BeaverHorror/STM32F407ZET6_MyPhone/Media/IMG_20260402_200926.jpg

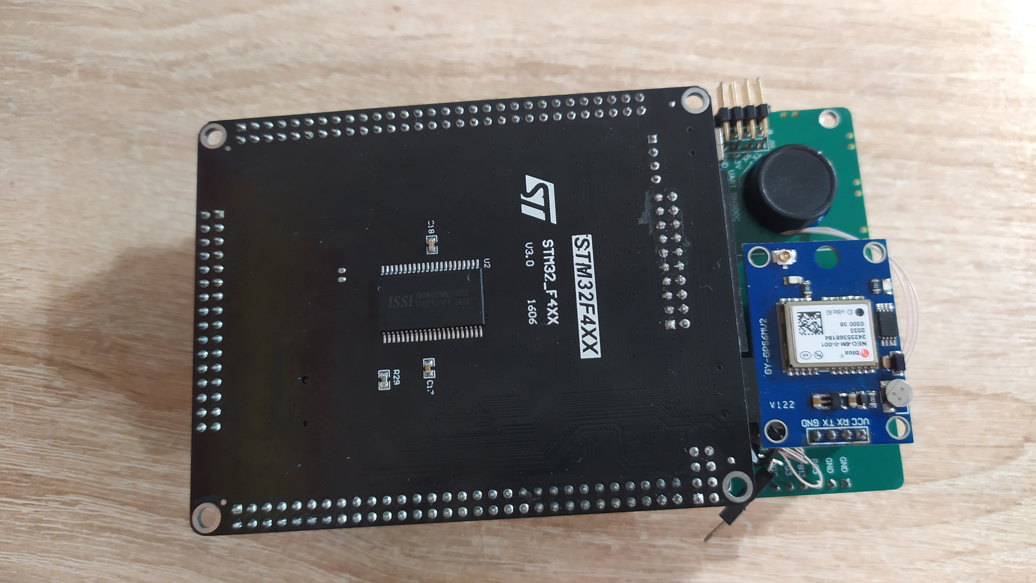
Media/IMG_20260402_200926.jpg
