BeaverHorror/STM32F407ZET6_MyPhone/Media/IMG_20260402_200939.jpg

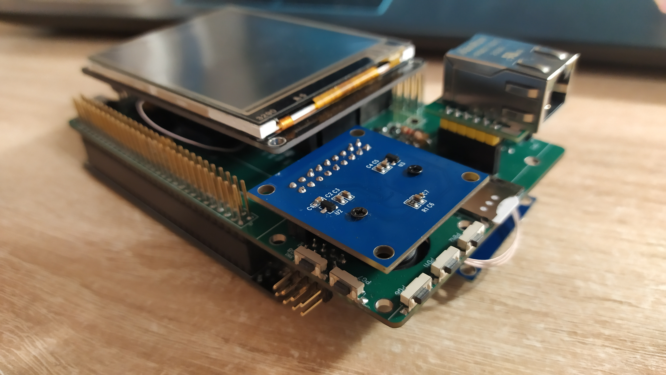
Media/IMG_20260402_200939.jpg
