BeaverHorror/STM32F407ZET6_MyPhone/Other/ESP8266_STM32_OTA_2022/OTA ESP8266 STM32 SIM800l.png

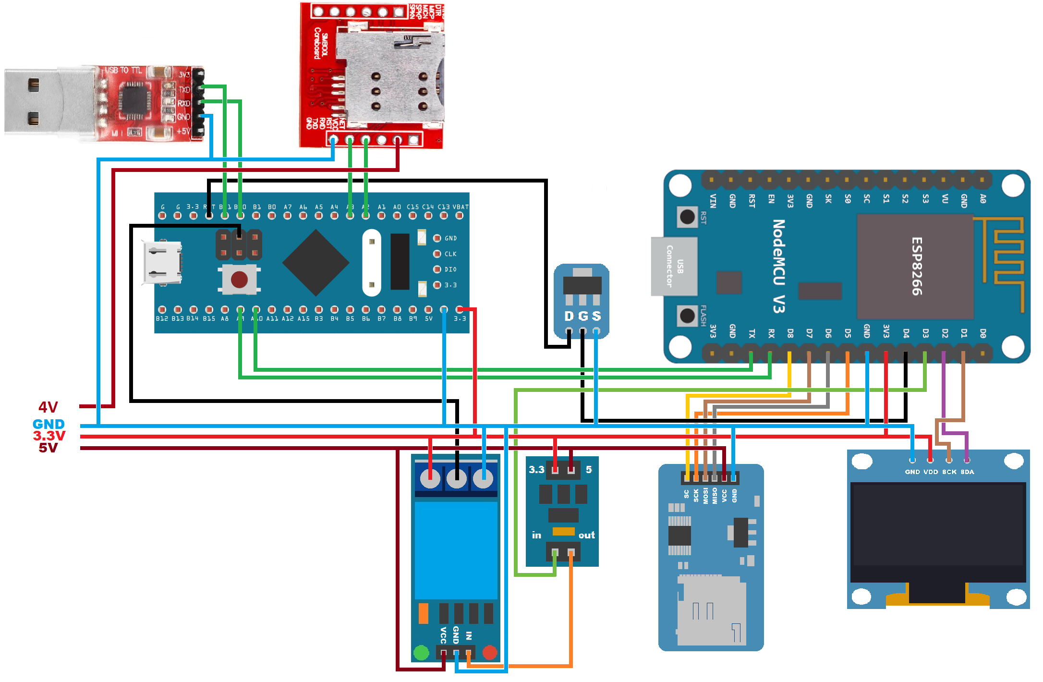
Other/ESP8266_STM32_OTA_2022/OTA ESP8266 STM32 SIM800l.png
