BeaverHorror/STM32F407ZET6_MyPhone/Other/pinset (1).png

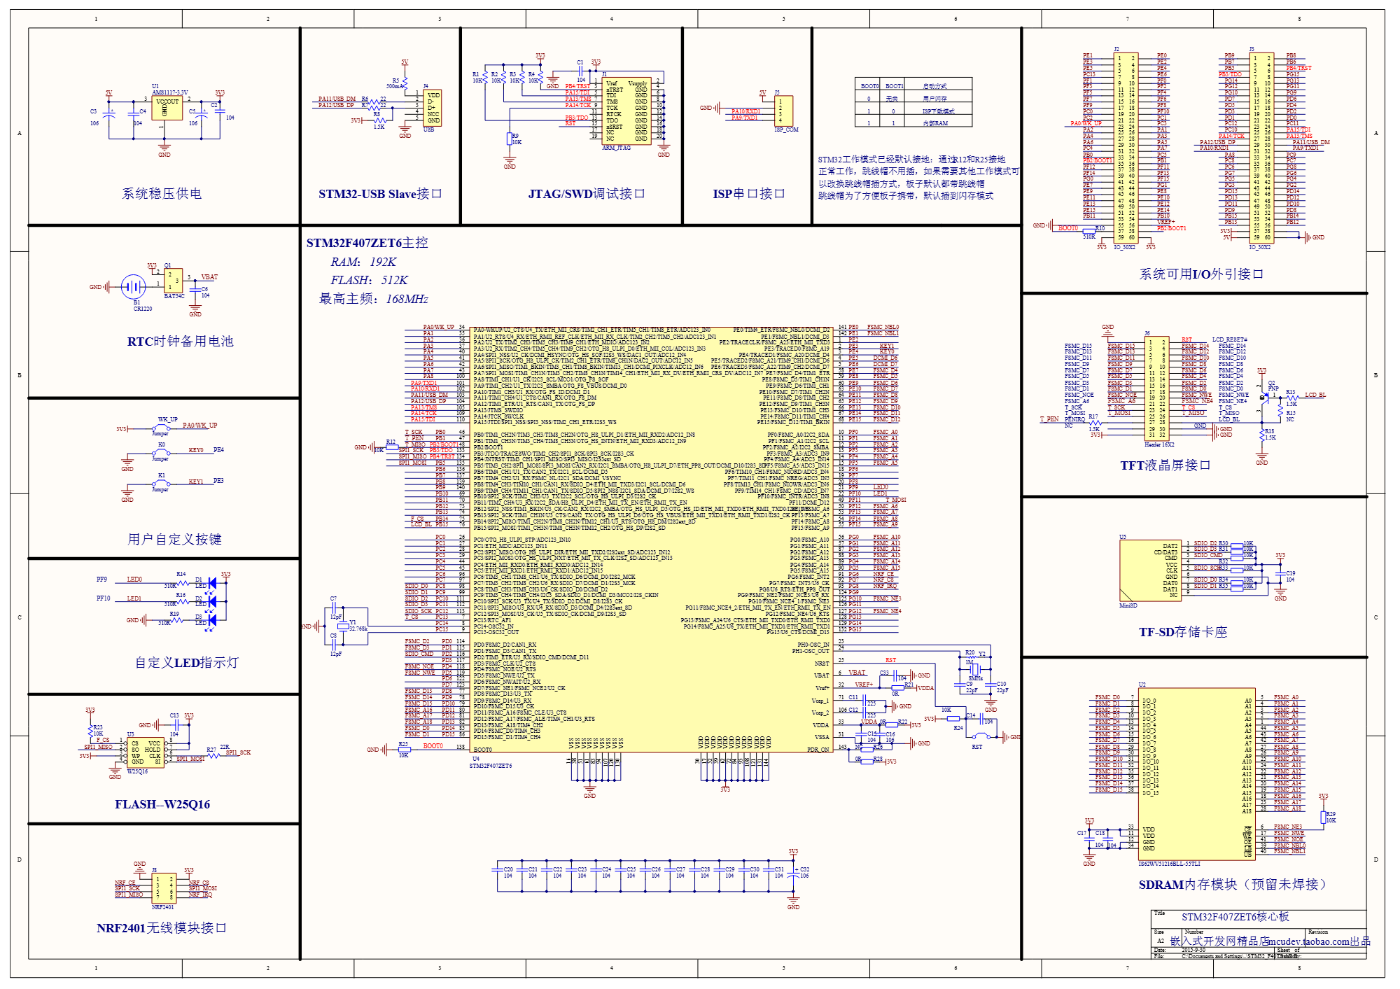
Other/pinset (1).png
