BeaverHorror/STM32F407ZET6_MyPhone/Other/pinset (2).png

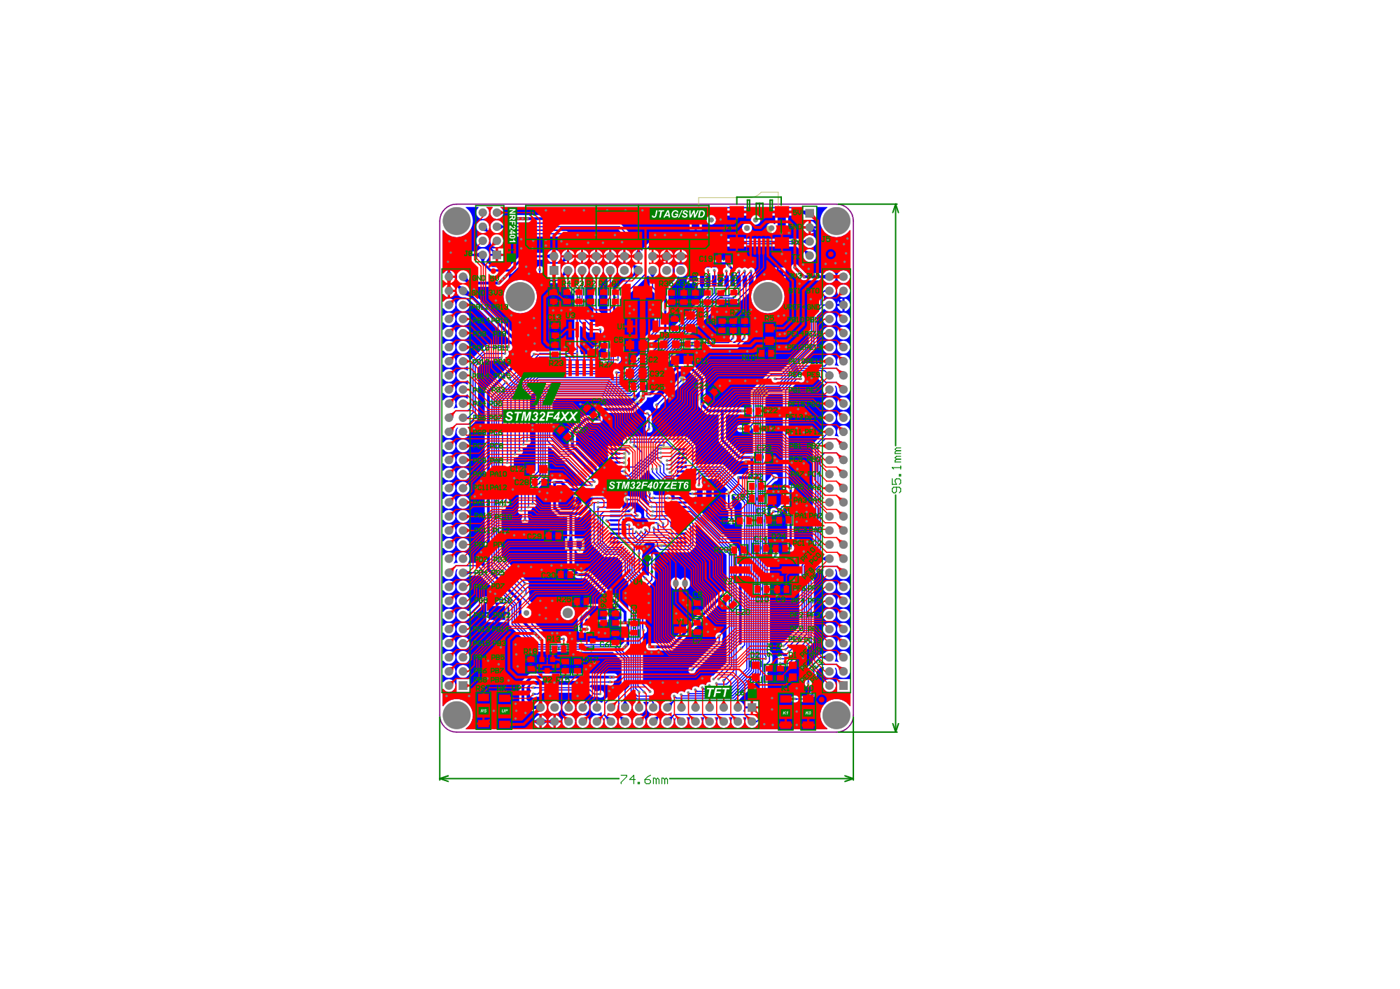
Other/pinset (2).png
