BeaverHorror/STM32F407ZET6_MyPhone/Other/pinset (3).png

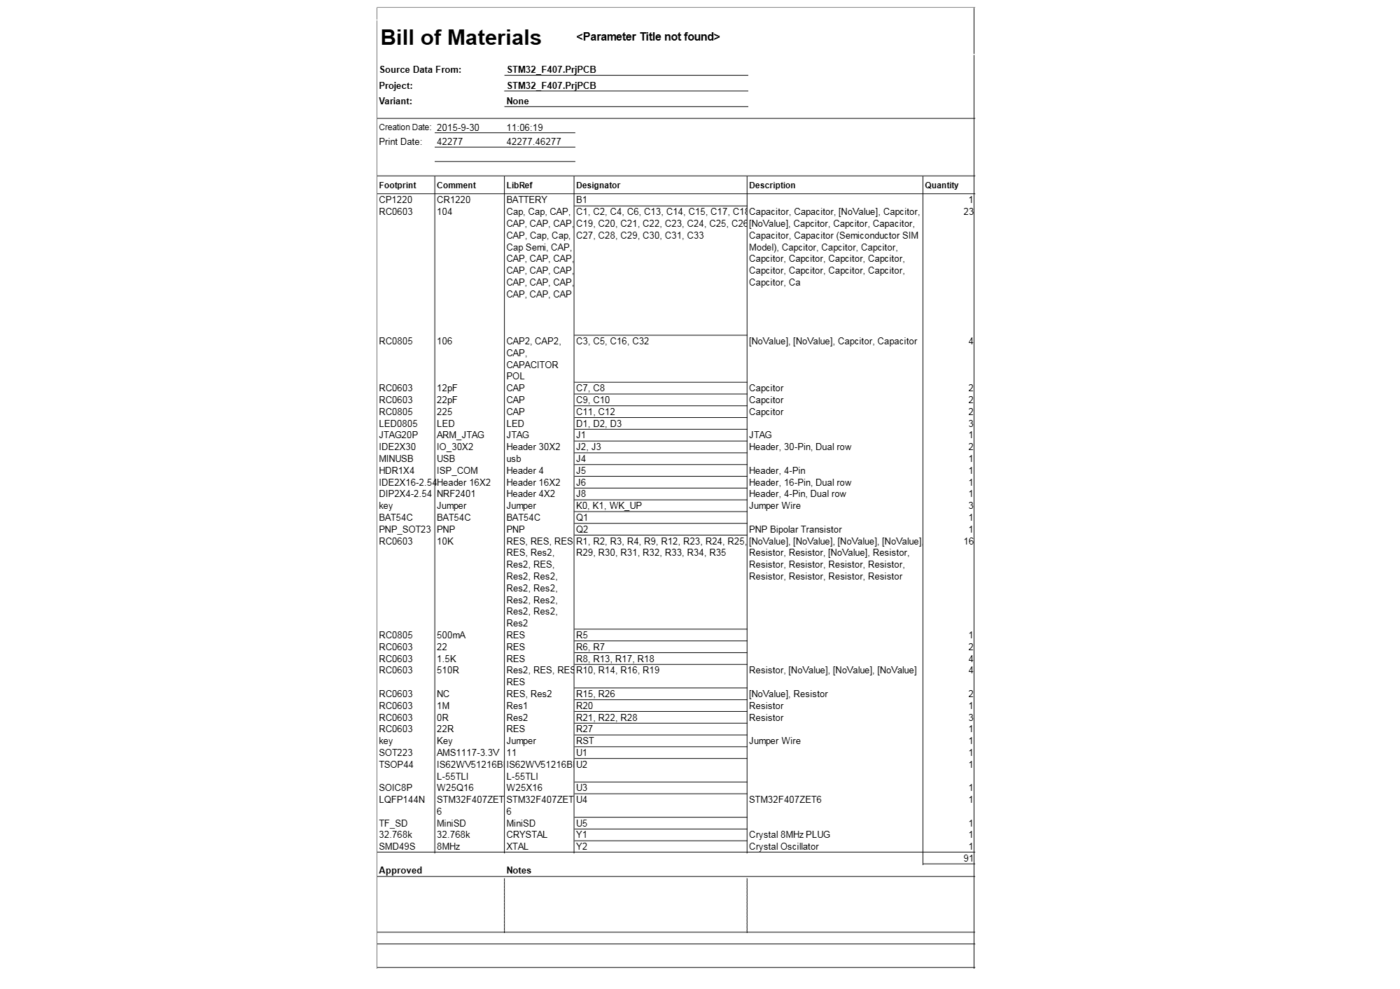
Other/pinset (3).png
