BeaverHorror/STM32F407ZET6_MyPhone/Other/загрузка (1).png

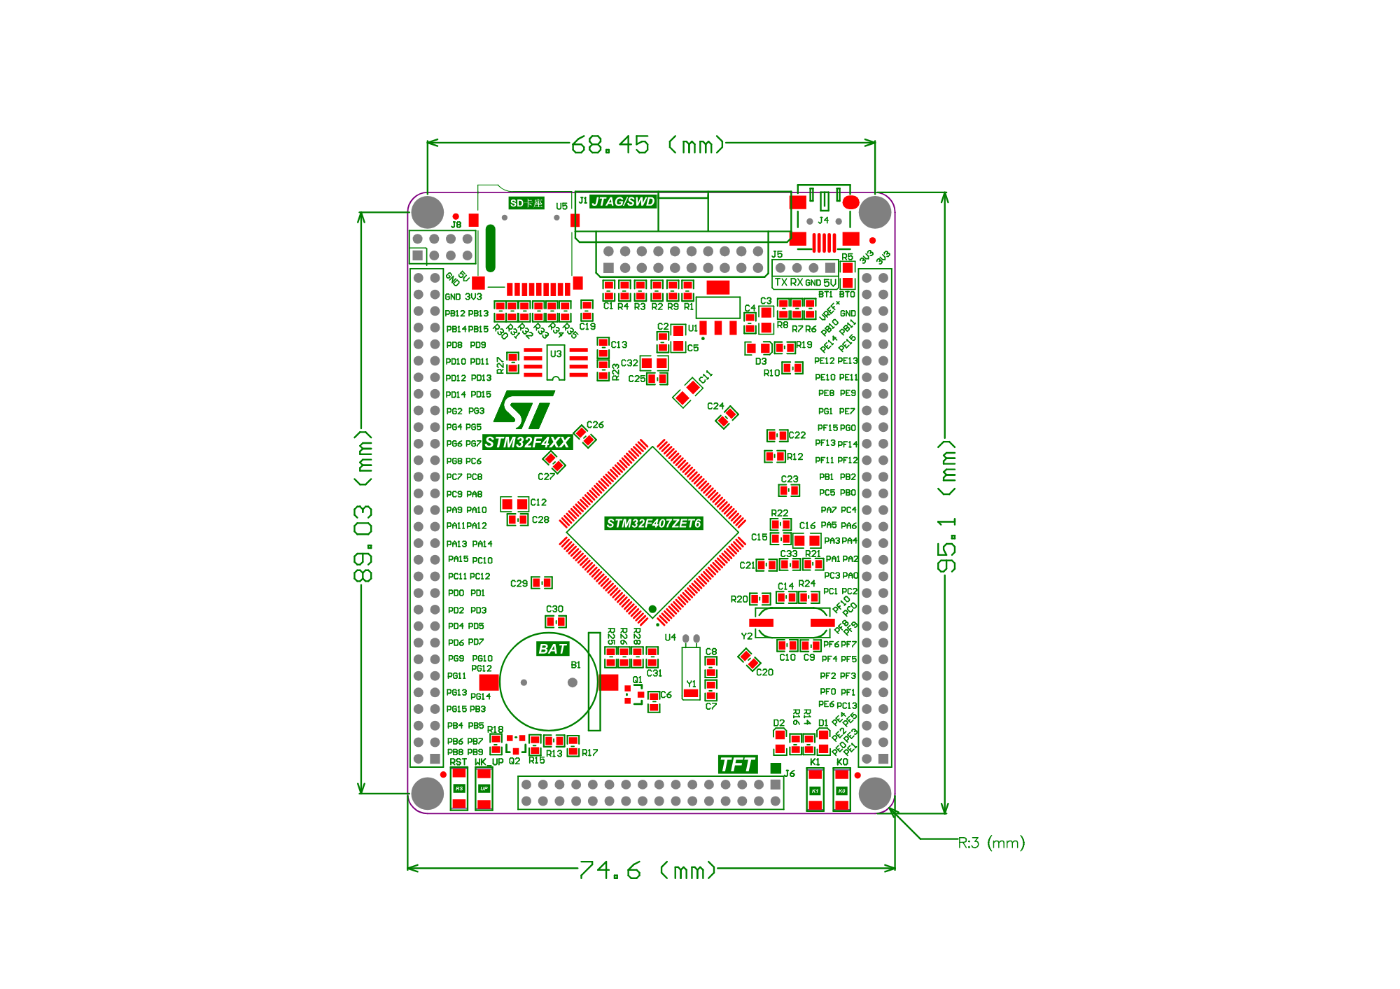
Other/загрузка (1).png
