BeaverHorror/STM32F407ZET6_MyPhone/Other/Скриншот 19-08-2025 135712.jpg

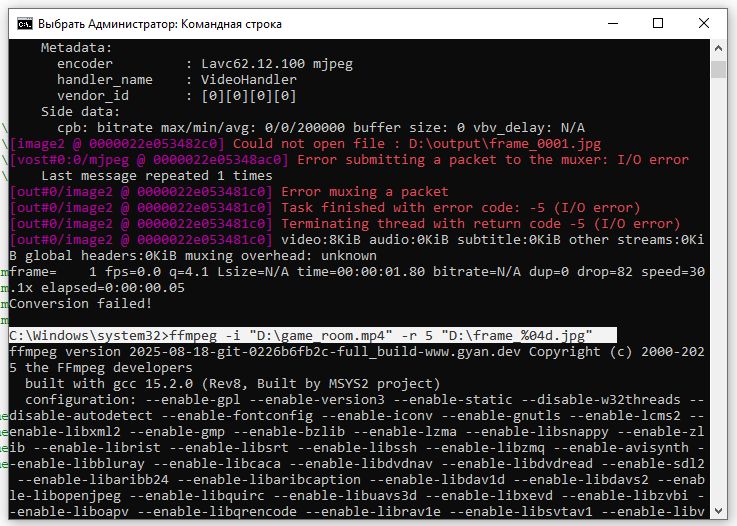
Other/Скриншот 19-08-2025 135712.jpg
