BeaverHorror/STM32F407ZET6_MyPhone/Schematic/Schematic_Communication_2026-04-02.png

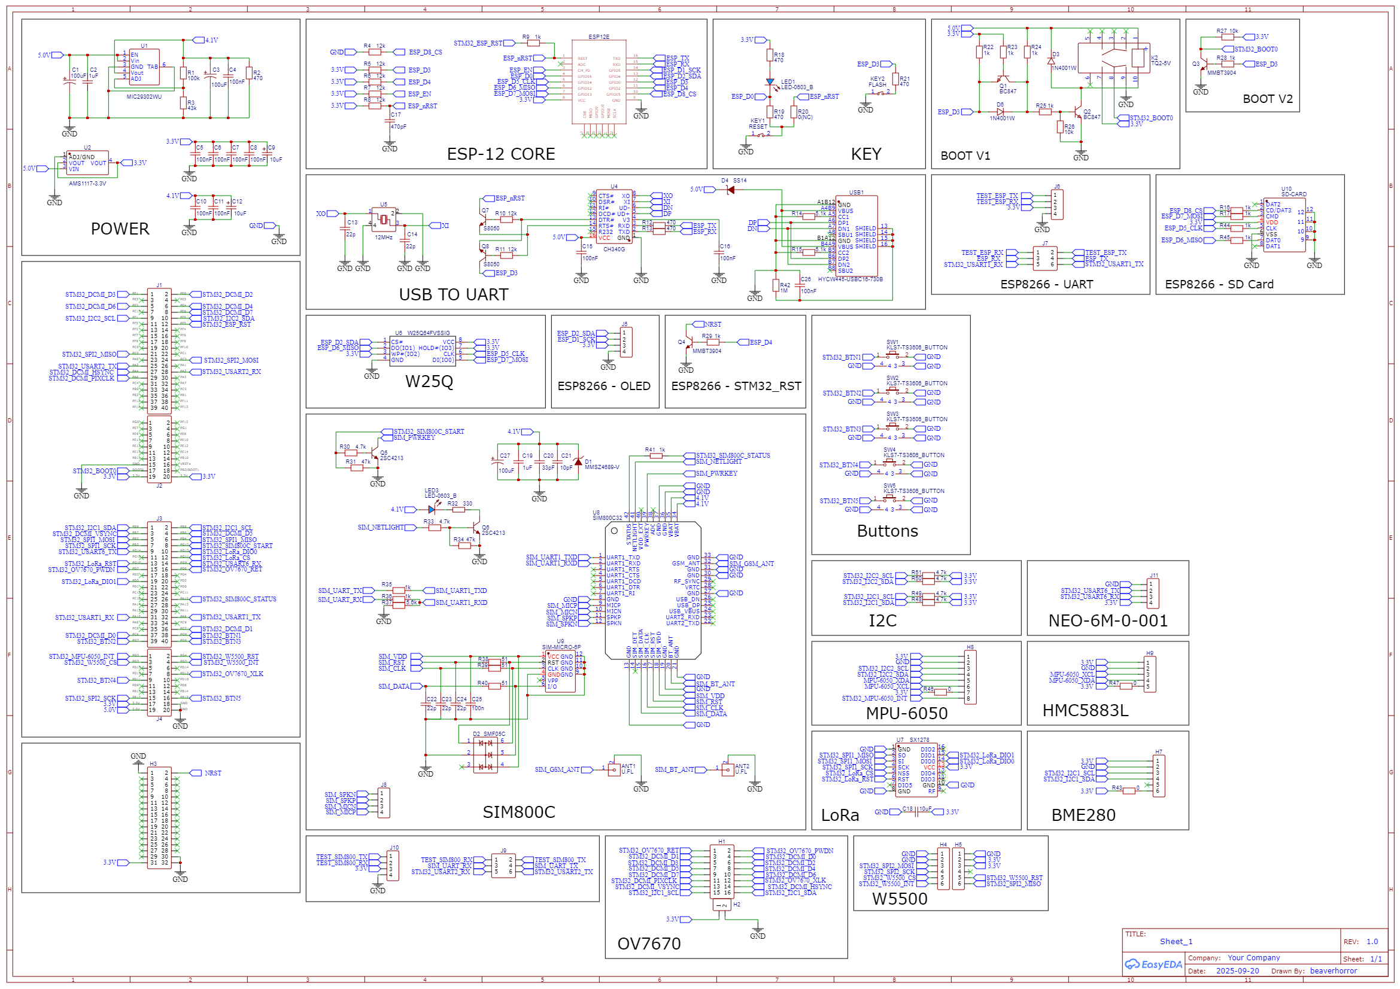
Schematic/Schematic_Communication_2026-04-02.png
