BeaverHorror/STM32F407ZET6_MyPhone/(list of files, drawings)

Other design files:
Schematic/PCB_PCB_Communication_6_2025-10-25.json
Schematic/SCH_Communication_2025-10-25.json
