BeaverHorror/STM32F407ZET6_MyPhone/(notices)

Notices in the files:
Other/rtc.c:
Copyright (c) 2024 STMicroelectronics.
All rights reserved.
This software is licensed under terms that can be found in the LICENSE file
